JimenaVega/TP-Final-Arquitectura-2021/img/diagrama_completo.png

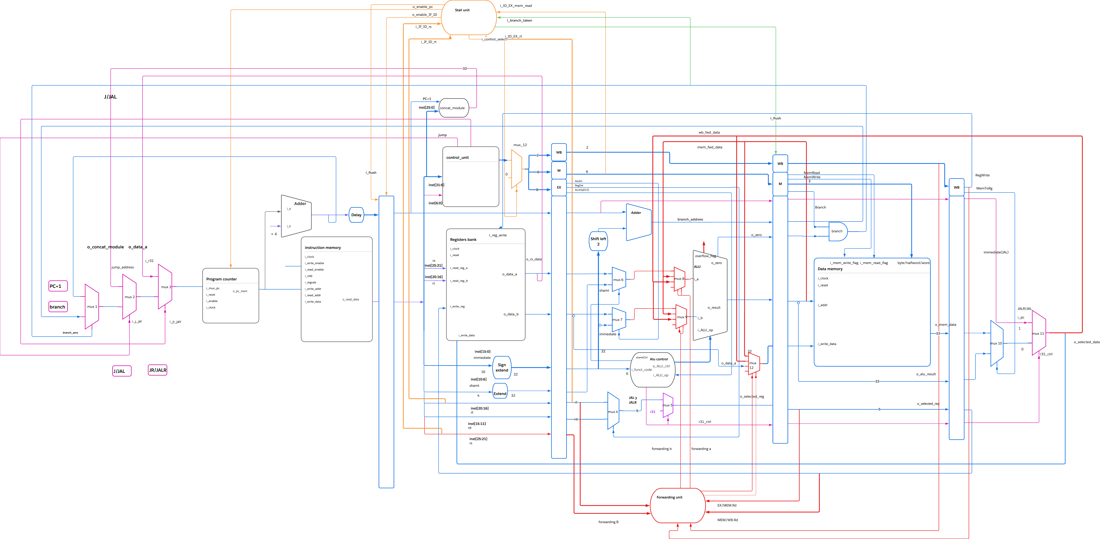
img/diagrama_completo.png
