JimenaVega/TP-Final-Arquitectura-2021/src/control_unit.v

`timescale 1ns / 1ps

module control_unit#(
        parameter   NB_OPCODE       = 6,
        parameter   NB_FUNCT        = 6,
        //Instruction OPCODEs
        parameter   RTYPE_OPCODE    = 6'h00,
        parameter   BEQ_OPCODE      = 6'h04, // ITYPE BEQ
        parameter   BNE_OPCODE      = 6'h05, // ITYPE BNE
        parameter   ADDI_OPCODE     = 6'h08, // ITYPE ADDI
        parameter   SLTI_OPCODE     = 6'h0a, // ITYPE SLTI
        parameter   ANDI_OPCODE     = 6'h0c, // ITYPE ANDI
        parameter   ORI_OPCODE      = 6'h0d, // ITYPE ORI
        parameter   XORI_OPCODE     = 6'h0e, // ITYPE XORI
        parameter   LUI_OPCODE      = 6'h0f, // ITYPE LUI
        parameter   LB_OPCODE       = 6'h20, // ITYPE LB
        parameter   LH_OPCODE       = 6'h21, // ITYPE LH
        parameter   LHU_OPCODE      = 6'h22, // ITYPE LHU
        parameter   LW_OPCODE       = 6'h23, // ITYPE LW
        parameter   LWU_OPCODE      = 6'h24, // ITYPE LWU
        parameter   LBU_OPCODE      = 6'h25, // ITYPE LBU
        parameter   SB_OPCODE       = 6'h28, // ITYPE SB
        parameter   SH_OPCODE       = 6'h29, // ITYPE SH
        parameter   SW_OPCODE       = 6'h2b, // ITYPE SW
        parameter   J_OPCODE        = 6'h02, // JTYPE J
        parameter   JAL_OPCODE      = 6'h03, // JTYPE JAL
        parameter   JALR_FUNCT      = 6'h09,
        parameter   JR_FUNCT        = 6'h08,
        parameter   HLT_OPCODE      = 6'h3f
    )
    (   input                       i_clock,
        input                       i_enable,
        input                       i_reset,        // Necesario para flush en controls hazard
        input [NB_OPCODE-1:0]       i_opcode,
        input [NB_FUNCT-1:0]        i_funct,
        input                       i_ctrl_sel,     // from STALL UNIT
        
        output reg                  o_signed,
        output reg                  o_reg_dest,     // EX
        output reg [NB_OPCODE-1:0]  o_alu_op,       // EX REG?
        output reg                  o_alu_src,      // EX
        output reg                  o_mem_read,     // MEM
        output reg                  o_mem_write,    // MEM
        output reg                  o_branch,       // MEM
        output reg                  o_reg_write,    // WB
        output reg                  o_mem_to_reg,   // WB
        output reg                  o_jump,
        output reg                  o_byte_en,
        output reg                  o_halfword_en,
        output reg                  o_word_en,
        output reg                  o_jr_jalr,      // Hacia register bank
        output reg                  o_hlt           // END OF PROGRAM
    );

    always@(posedge i_clock) begin
        if(i_reset) begin
            o_alu_op        <= {NB_OPCODE{1'b0}};
            o_signed        <= 1'b0;
            o_reg_dest      <= 1'b0;
            o_alu_src       <= 1'b0;
            o_mem_read      <= 1'b0;
            o_mem_write     <= 1'b0;
            o_branch        <= 1'b0;
            o_reg_write     <= 1'b0;
            o_mem_to_reg    <= 1'b0;
            o_jump          <= 1'b0;
            o_jr_jalr       <= 1'b0;
            o_byte_en       <= 1'b0;
            o_halfword_en   <= 1'b0;
            o_word_en       <= 1'b0;
            o_hlt           <= 1'b0;
        end
        if(i_enable) begin
            if(!i_ctrl_sel) begin
                o_alu_op <= i_opcode;
                case(i_opcode)
                    RTYPE_OPCODE:begin
                        o_signed        <= 1'b0;
                        o_reg_dest      <= 1'b1; // rd
                        o_alu_src       <= 1'b0; // rt
                        o_mem_read      <= 1'b0; // no accede a mem
                        o_mem_write     <= 1'b0; // no accede a mem
                        o_branch        <= 1'b0; // no es branch
                        o_reg_write     <= 1'b1; // escribe en bank register
                        o_mem_to_reg    <= 1'b0; // read salida ALU
                        o_jump          <= 1'b0;
                        o_byte_en       <= 1'b0;
                        o_halfword_en   <= 1'b0;
                        o_word_en       <= 1'b0;
                        o_hlt           <= 1'b0;

                        if((i_funct == JALR_FUNCT) || (i_funct == JR_FUNCT)) begin
                            o_jr_jalr <= 1'b1; // Ambas escriben en el PC=$rs
                        end
                        else begin
                            o_jr_jalr <= 1'b0;
                        end

                    end
                    BEQ_OPCODE:begin
                        o_signed        <= 1'b0;
                        o_reg_dest      <= 1'b0; // X
                        o_alu_src       <= 1'b0; // rt
                        o_mem_read      <= 1'b0; // no accede a mem
                        o_mem_write     <= 1'b0; // no accede a mem
                        o_branch        <= 1'b1; // es branch
                        o_reg_write     <= 1'b0; // no escribe en bank register
                        o_mem_to_reg    <= 1'b0; // X
                        o_jump          <= 1'b0;
                        o_byte_en       <= 1'b0;
                        o_halfword_en   <= 1'b0;
                        o_word_en       <= 1'b0;
                        o_jr_jalr       <= 1'b0;
                        o_hlt           <= 1'b0;
                    end
                    BNE_OPCODE:begin
                        o_signed        <= 1'b0;
                        o_reg_dest      <= 1'b0; // X
                        o_alu_src       <= 1'b0; // rt
                        o_mem_read      <= 1'b0; // no accede a mem
                        o_mem_write     <= 1'b0; // no accede a mem
                        o_branch        <= 1'b1; // es branch
                        o_reg_write     <= 1'b0; // no escribe en bank register
                        o_mem_to_reg    <= 1'b0; // X
                        o_jump          <= 1'b0;
                        o_byte_en       <= 1'b0;
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
                        o_signed        <= 1'b0;
                        o_reg_dest      <= 1'b0; // rt
                        o_alu_src       <= 1'b0; // immediate
                        o_mem_read      <= 1'b0; // no read mem
                        o_mem_write     <= 1'b0; // no write mem
                        o_branch        <= 1'b0; // no es branch
                        o_reg_write     <= 1'b0; // escribe en rt
                        o_mem_to_reg    <= 1'b0; // X
                        o_jump          <= 1'b1;
                        o_byte_en       <= 1'b0;
                        o_halfword_en   <= 1'b0;
                        o_word_en       <= 1'b0;
                        o_jr_jalr       <= 1'b0;
                        o_hlt           <= 1'b0;
                    end
                    JAL_OPCODE:begin
                        o_signed        <= 1'b0;
                        o_reg_dest      <= 1'b0; // rt
                        o_alu_src       <= 1'b0; // immediate
                        o_mem_read      <= 1'b0; // no read mem
                        o_mem_write     <= 1'b0; // no write mem
                        o_branch        <= 1'b0; // no es branch
                        o_reg_write     <= 1'b1; // escribe en rt
                        o_mem_to_reg    <= 1'b0; // X
                        o_jump          <= 1'b1; // TODO: ver si se necesta señal que haga $ra=PC+1
                        o_byte_en       <= 1'b0;
                        o_halfword_en   <= 1'b0;
                        o_word_en       <= 1'b0;
                        o_jr_jalr       <= 1'b0;
                        o_hlt           <= 1'b0;
                    end
                    HLT_OPCODE:begin
                        o_signed        <= 1'b0;
                        o_reg_dest      <= 1'b0; // rt
                        o_alu_src       <= 1'b0; // immediate
                        o_mem_read      <= 1'b0; // no read mem
                        o_mem_write     <= 1'b0; // no write mem
                        o_branch        <= 1'b0; // no es branch
                        o_reg_write     <= 1'b0; // escribe en rt
                        o_mem_to_reg    <= 1'b0; // X
                        o_jump          <= 1'b0; // dont jump
                        o_byte_en       <= 1'b0;
                        o_halfword_en   <= 1'b0;
                        o_word_en       <= 1'b0;
                        o_jr_jalr       <= 1'b0;
                        o_hlt           <= 1'b1; // END OF PROGRAM
                    end
                    default: begin
                        o_signed        <= 1'b0;
                        o_reg_dest      <= 1'b0; // rt
                        o_alu_src       <= 1'b0; // immediate
                        o_mem_read      <= 1'b0; // no read mem
                        o_mem_write     <= 1'b0; // no write mem
                        o_branch        <= 1'b0; // no es branch
                        o_reg_write     <= 1'b0; // escribe en rt
                        o_mem_to_reg    <= 1'b0; // X
                        o_jump          <= 1'b0; // dont jump
                        o_byte_en       <= 1'b0;
                        o_halfword_en   <= 1'b0;
                        o_word_en       <= 1'b0;
                        o_jr_jalr       <= 1'b0;
                        o_hlt           <= 1'b0; // END OF PROGRAM
                    end
                endcase
            end
            else begin
                    // flush from STALL UNIT 
                    o_signed        <= 1'b0;
                    o_reg_dest      <= 1'b0; // rt
                    o_alu_src       <= 1'b0; // immediate
                    o_mem_read      <= 1'b0; // no read mem
                    o_mem_write     <= 1'b0; // no write mem
                    o_branch        <= 1'b0; // no es branch
                    o_reg_write     <= 1'b0; // escribe en rt
                    o_mem_to_reg    <= 1'b0; // X
                    o_jump          <= 1'b0; // dont jump
                    o_byte_en       <= 1'b0;
                    o_halfword_en   <= 1'b0;
                    o_word_en       <= 1'b0;
                    o_jr_jalr       <= 1'b0;
                    o_hlt           <= 1'b0; // END OF PROGRAM
            end
        end
        // else begin
        //     o_alu_op        <= {NB_OPCODE{1'b0}};
        //     o_signed        <= 1'b0;
        //     o_reg_dest      <= 1'b0;
        //     o_alu_src       <= 1'b0;
        //     o_mem_read      <= 1'b0;
        //     o_mem_write     <= 1'b0;
        //     o_branch        <= 1'b0;
        //     o_reg_write     <= 1'b0;
        //     o_mem_to_reg    <= 1'b0;
        //     o_jump          <= 1'b0;
        //     o_jr_jalr       <= 1'b0;
        //     o_hlt           <= 1'b0;
        // end
    end
endmodule
    
