JimenaVega/TP-Final-Arquitectura-2021/src/debug_unit.v

`timescale 1ns / 1ps

module debug_unit#(
    parameter NB_STATE    = 10,
    parameter NB_DATA     = 8,
    parameter NB_SIZE     = 16, // 2B x 8 b, el tamaño de los datos a recibir en bits
    parameter N_SIZE      = 2,  // 2B de frame para obtener el total de los datos (size)
    parameter NB_ADDR     = 32,
    parameter NB_ADDR_RB  = 5,
    parameter NB_BYTE_CTR = 2,
    parameter NB_ADDR_DM  = 5, 
    parameter BR_SIZE     = 32,
    parameter DM_DEPTH    = 32,
    parameter DM_WIDTH    = 32,
    parameter RB_DEPTH    = 32,
    parameter IM_DEPTH    = 256,
    parameter NB_PC_CTR   = 2
)    
(
    input                   i_clock,
    input                   i_reset,
    input                   i_hlt,          // proveniente del DATAPATH
    input                   i_rx_done,      // meaning: RX tiene un byte listo para ser leido - UART
    input                   i_tx_done,      // meaning: TX ya envio el byte - UART
    input  [NB_DATA-1:0]    i_rx_data,      // from RX - UART

    input  [NB_ADDR-1:0]    i_pc_value,     // *  data read from PC 
    input  [DM_WIDTH-1:0]   i_dm_data,      // * data read from DATA MEMORY
    input  [NB_ADDR-1:0]    i_br_data,      // *  data read from BANK REGISTER
    output [NB_DATA-1:0]    o_im_data,      // *  data to write in INSTRUCTION MEMORY

    output [NB_DATA-1:0]    o_im_addr,      //  * address to write INSTRUCTION MEMORY
    output [NB_ADDR_RB-1:0] o_rb_addr,      // * address to read BANK REGISTER
    output [NB_ADDR_DM-1:0] o_dm_addr,      // * address to read DATA MEMORY

    output [NB_DATA-1:0]    o_tx_data,      // to TX - UART
    output                  o_tx_start,     // to TX - UART

    output                  o_im_write_enable, //*
    output                  o_im_read_enable,
    output                  o_im_enable, //*
    output                  o_rb_read_enable, // * 
    output                  o_rb_enable, // * Usar solo cuando se active funcionamiento normal de datapath
    output                  o_dm_enable, // *
    output                  o_dm_read_enable, // *
    output                  o_dm_du_flag, // *
    output                  o_cu_enable,
    output                  o_pc_enable, // *

    // output                  o_step_flag,
    // output                  o_step,
    output [NB_STATE-1:0]   o_state,
    output                  o_pipeline_enable
);

// States
localparam [NB_STATE-1:0] IDLE         = 10'b0000000001;
localparam [NB_STATE-1:0] WRITE_IM     = 10'b0000000010;
localparam [NB_STATE-1:0] READY        = 10'b0000000100;
localparam [NB_STATE-1:0] START        = 10'b0000001000;
localparam [NB_STATE-1:0] STEP_BY_STEP = 10'b0000010000;
localparam [NB_STATE-1:0] READ_BR      = 10'b0000100000;
localparam [NB_STATE-1:0] SEND_BR      = 10'b0001000000;
localparam [NB_STATE-1:0] READ_MEM     = 10'b0010000000;
localparam [NB_STATE-1:0] SEND_MEM     = 10'b0100000000;
localparam [NB_STATE-1:0] SEND_PC      = 10'b1000000000;

// External commands
localparam [NB_DATA-1:0] CMD_WRITE_IM       = 8'd1; // Escribir programa
localparam [NB_DATA-1:0] CMD_START          = 8'd2; // Ejecucion continua
localparam [NB_DATA-1:0] CMD_STEP_BY_STEP   = 8'd3; // Step-by-step
localparam [NB_DATA-1:0] CMD_SEND_BR        = 8'd4; // Leer bank register
localparam [NB_DATA-1:0] CMD_SEND_MEM       = 8'd5; // Leer data memory
localparam [NB_DATA-1:0] CMD_SEND_PC        = 8'd6; // Leer PC
localparam [NB_DATA-1:0] CMD_STEP           = 8'd7; // Send step
localparam [NB_DATA-1:0] CMD_CONTINUE       = 8'd8; // Continue execution >>


// FSM logic
reg [NB_STATE-1:0]      state,              next_state,     prev_state,   next_prev_state;

// INSTRUCTION MEMORY
reg [NB_DATA-1:0]       im_count,           next_im_count;          // Address a escribir
reg                     im_write_enable,    next_im_write_enable;   // Flag que habilita la escritura del IM
reg                     im_read_enable,     next_im_read_enable;
reg                     im_enable,          next_im_enable;

// DATA MEMORY
reg [NB_ADDR_DM-1:0]    count_dm_tx_done,   count_dm_tx_done_next;  // Address
reg [NB_BYTE_CTR-1:0]   count_dm_byte,      next_count_dm_byte;
reg                     dm_read_enable,     next_dm_read_enable;
reg                     dm_enable,          next_dm_enable;
reg                     dm_du_flag,         next_dm_du_flag;     // selector de address y flag de DU
// BANK REGISTER
reg [NB_ADDR_RB-1:0]    count_br_tx_done,   next_count_br_tx_done; 
reg [NB_BYTE_CTR-1:0]   count_br_byte,      next_count_br_byte;     // cuenta hasta 4 bytes
reg                     rb_read_enable,     next_rb_read_enable;
reg                     rb_enable,          next_rb_enable;

// PC
reg [NB_PC_CTR-1:0]     count_pc,           next_count_pc;
reg                     pc_enable,          next_pc_enable; // 1 -> ejecucion de datapath 0 ->  modo lectura 

// CONTROL UNIT
reg                     cu_enable,          next_cu_enable;

// TX
reg [NB_DATA-1:0]       send_data,          next_send_data;         // DM & BR -> TX
reg                     tx_start,           tx_start_next;

// STEPPER
// reg                     step_flag,          next_step_flag;
// reg                     step,               next_step;

// PIPELINE REGISTERS
reg                    pipeline_enable,     next_pipeline_enable;


// always@(negedge i_clock) begin
//     if (i_reset) begin
//         im_read_enable_delay <= 1'b0;
//         im_enable_delay <= 1'b0;
//         rb_read_enable_delay <= 1'b0;
//         rb_enable_delay <= 1'b0;
//         pipeline_enable_delay <= 1'b0;
//     end
//     else begin
//         im_read_enable_delay <= im_read_enable;
//         im_enable_delay <= im_enable_delay;
//         rb_read_enable_delay <= rb_read_enable;
//         rb_enable_delay <= rb_enable;
//         pipeline_enable_delay <= pipeline_enable;
//     end
    
// end


// Memory
always @(negedge i_clock) begin
    if(i_reset) begin
        state                   <= IDLE;
        prev_state              <= IDLE;

        // INSTRUCTION MEMORY 
        im_write_enable         <= 1'b0;
        im_read_enable          <= 1'b0;
        im_enable               <= 1'b0;
        im_count                <= 8'hff;

        // DATA MEMORY
        count_dm_tx_done        <= 5'b0;
        count_dm_byte           <= 2'b0;
        dm_enable               <= 1'b0;
        dm_read_enable          <= 1'b0;
        dm_du_flag              <= 1'b0;

        // REGISTERS BANK
        count_br_tx_done        <= 5'b0;
        count_br_byte           <= 2'b0;
        rb_enable               <= 1'b0;
        rb_read_enable          <= 1'b0;

        // PC
        pc_enable               <= 1'b0;
        count_pc                <= 2'b0;

        // CONTROL UNIT
        cu_enable               <= 1'b0;
        
        // TX
        send_data               <= 8'b0;
        tx_start                <= 1'b0;

        // STEPPER
//        step_flag               <= 1'b0;
//        step                    <= 1'b0;

        pipeline_enable         <= 1'b0;


    end
    else begin
        state               <= next_state;
        prev_state          <= next_prev_state;
        // INSTRUCTION MEMORY
        im_write_enable     <= next_im_write_enable;
        im_read_enable      <= next_im_read_enable;
        im_enable           <= next_im_enable;
        im_count            <= next_im_count;
        // DATA MEMORY
        dm_enable           <= next_dm_enable;
        dm_read_enable      <= next_dm_read_enable;
        count_dm_byte       <= next_count_dm_byte;
        count_dm_tx_done    <= count_dm_tx_done_next;
        dm_du_flag          <= next_dm_du_flag;
        // REGISTERS BANK
        rb_enable           <= next_rb_enable;
        rb_read_enable      <= next_rb_read_enable;
        count_br_byte       <= next_count_br_byte;
        count_br_tx_done    <= next_count_br_tx_done;
        tx_start            <= tx_start_next;
        // PC
        pc_enable           <= next_pc_enable;
        count_pc            <= next_count_pc;
        // step_flag           <= next_step_flag;
//        step                <= next_step;
        // CONTROL UNIT
        cu_enable           <= next_cu_enable;
        // TX
        send_data           <= next_send_data;

        pipeline_enable     <= next_pipeline_enable;

    end
end

// Next sate logic
always @(*) begin
    next_state              = state;

    next_dm_enable          = dm_enable;
    next_dm_read_enable     = dm_read_enable;
    next_dm_du_flag         = dm_du_flag;
    next_count_dm_byte      = count_dm_byte;
    count_dm_tx_done_next   = count_dm_tx_done;

    next_count_br_byte      = count_br_byte;
    next_count_br_tx_done   = count_br_tx_done;

    next_count_pc           = count_pc;
    next_pc_enable          = pc_enable;

    next_im_enable          = im_enable;
    next_im_write_enable    = im_write_enable;
    next_im_read_enable     = im_read_enable;
    next_im_count           = im_count;

    next_rb_enable          = rb_enable;
    next_rb_read_enable     = rb_read_enable;

    next_send_data          = send_data;
    next_cu_enable          = cu_enable;
    next_pipeline_enable    = pipeline_enable;
   
    tx_start_next           = tx_start;

    // next_step_flag          = step_flag;
    // next_step               = step;

    next_prev_state         = prev_state;

    case(state)
        IDLE: begin
            // next_step_flag      = 1'b0;
            // next_step           = 1'b0; // deshabilito las flags

            next_im_enable       = 1'b0;
            next_im_write_enable = 1'b0;
            next_im_read_enable  = 1'b0;

            next_rb_enable       = 1'b0;
            next_rb_read_enable  = 1'b0;

            next_dm_enable       = 1'b0;
            next_dm_read_enable  = 1'b0;
            next_dm_du_flag      = 1'b0;

            next_cu_enable       = 1'b0;
            next_pc_enable       = 1'b0;
            next_pipeline_enable = 1'b0;

            next_send_data       = 8'b0;


            if(i_rx_done) begin
                case (i_rx_data)
                    CMD_WRITE_IM:  begin
                        next_state = WRITE_IM;
                        next_prev_state = IDLE;
                    end
                    CMD_SEND_BR:begin
                        next_rb_read_enable = 1'b1; // Read enable = register bank con lectura para debug unit
                        next_rb_enable      = 1'b0; // Enable = register bank con lectura en funcionamiento normal

                        next_state = READ_BR;
                        
                        next_prev_state = IDLE;
                    end
                    CMD_SEND_PC:begin
                        next_state = SEND_PC;
                        next_prev_state = IDLE;
                    end
                    CMD_SEND_MEM:begin
                        next_dm_read_enable     = 1'b1;
                        next_dm_enable          = 1'b1;
                        next_dm_du_flag         = 1'b1; // select DU as address and read enable source

                        next_state = READ_MEM;
                        next_prev_state = IDLE;
                    end
                endcase
            end
        end
        READY: begin
            // next_step = 1'b0; // deshabilito las flags
            if(i_rx_done)begin
                case(i_rx_data)
                    CMD_STEP_BY_STEP:   next_state = STEP_BY_STEP;
                    CMD_START:          next_state = START;
                    // default:            next_state = READY;
                endcase
            end
        end
        START: begin
            // next_step_flag  = 1'b0;
            // next_step           = 1'b1; 

            next_im_enable      = 1'b1;
            next_im_read_enable = 1'b1;
            next_rb_enable      = 1'b1;
            next_dm_enable      = 1'b1;
            next_cu_enable      = 1'b1;
            next_pc_enable      = 1'b1;
            next_pipeline_enable = 1'b1;

            if(i_hlt)begin
                next_state = IDLE;
            end
        end
        STEP_BY_STEP: begin
            // next_step_flag  = 1'b1; // STOP 50MHz ckock
            // next_step           = 1'b0;

    

            if(i_rx_done)begin
                next_pipeline_enable = 1'b1;
                case (i_rx_data)
                    CMD_STEP: begin
                        next_state  = SEND_PC;
                        next_prev_state  = STEP_BY_STEP;
                        // next_step   = 1'b1;
                        next_im_enable      = 1'b1;
                        next_im_read_enable = 1'b1;
                        next_rb_enable      = 1'b1;
                        next_dm_enable      = 1'b1;
                        next_cu_enable      = 1'b1;
                        
                        next_pc_enable      = 1'b1;
                    end
                    CMD_CONTINUE: begin
                        next_state = START;
                        next_prev_state = IDLE;
                    end    
                endcase
            end

            if(i_hlt)begin
                next_state = IDLE;
                next_prev_state = IDLE;
            end
        end
        WRITE_IM: begin
            // next_step = 1'b1;
            if(im_count == 8'd254)begin
                next_state              = READY;
                next_im_enable          = 1'b0;
                next_im_read_enable     = 1'b0;
                next_im_write_enable    = 1'b0;
                next_im_count           = 8'hff;
            end
            else begin
                if(i_rx_done)begin
                    next_im_enable          = 1'b1;
                    next_im_write_enable    = 1'b1;
                    next_im_read_enable     = 1'b0;
                    next_im_count           = im_count + 1;
                    next_state              = WRITE_IM;
                end
                else begin
                    next_im_enable          = 1'b0;
                    next_im_write_enable    = 1'b0;
                    next_im_read_enable     = 1'b0;
                end
            end
        end
        SEND_PC: begin
            tx_start_next       = 1'b1;
            // next_step           = 1'b1;

            next_im_enable      = 1'b0;
            next_im_read_enable = 1'b0;
            next_rb_enable      = 1'b0;
            next_dm_enable      = 1'b0;
            next_cu_enable      = 1'b0;
            next_pc_enable      = 1'b0;
            next_pipeline_enable = 1'b0;
            

            case(count_pc)
                2'd0:   next_send_data = i_pc_value[31:24];
                2'd1:   next_send_data = i_pc_value[23:16];
                2'd2:   next_send_data = i_pc_value[15:8];
                2'd3:   next_send_data = i_pc_value[7:0];
            endcase

            if(i_tx_done)begin
                tx_start_next = 1'b0;
                if(count_pc == 2'd3)begin
                    next_pipeline_enable = 1'b0; // por que aca?
                    tx_start_next = 1'b0;
                    next_count_pc = 2'b0;
                    if(prev_state == STEP_BY_STEP)begin
                        next_state = SEND_MEM;
                    end
                    else begin
                        next_state = IDLE;
                    end
                end
                else begin
                    next_count_pc = count_pc + 1;
                    next_state = SEND_PC;
                end
            end
        end
        READ_BR: begin
            next_state = SEND_BR;
        end
        SEND_BR: begin
            next_rb_read_enable = 1'b1; // Read enable = register bank con lectura para debug unit
            next_rb_enable      = 1'b0; // Enable = register bank con lectura en funcionamiento normal
            
            tx_start_next       = 1'b1;
            // next_step           = 1'b1;
            // next_step_flag      = 1'b0; // Se alimenta el datapath con clk de 50MHz

            //disable all except br
            next_pc_enable      = 1'b0;
            next_cu_enable      = 1'b0;
            // next_pipeline_enable = 1'b1; //0
            next_dm_enable      = 1'b0;

            case(next_count_br_byte)
                2'd0:   next_send_data = i_br_data[31:24];
                2'd1:   next_send_data = i_br_data[23:16];
                2'd2:   next_send_data = i_br_data[15:8];
                2'd3:   next_send_data = i_br_data[7:0];
            endcase

            if(i_tx_done)begin
                next_count_br_byte = next_count_br_byte + 1;
                tx_start_next = 1'b0;

                if(count_br_byte == 2'd3)begin
                    next_count_br_tx_done   = count_br_tx_done + 1; // BR address
                    next_count_br_byte      = 2'd0;
                    next_state              = READ_BR;

                    if(count_br_tx_done == RB_DEPTH-1)begin
                        next_rb_read_enable  = 1'b0;
                        tx_start_next        = 1'b0;
                        next_state           = prev_state;
                        tx_start_next        = 1'b0;                    
                    end
                end
            end
        end
        READ_MEM:begin
            next_state = SEND_MEM;
        end
        SEND_MEM: begin
            next_dm_read_enable     = 1'b1;
            next_dm_enable          = 1'b1;
            next_dm_du_flag         = 1'b1; // select DU as address and read enable source
            
            tx_start_next           = 1'b1;
            // next_step               = 1'b1;
            // next_step_flag          = 1'b0;

            // disable all except dm 
            next_im_enable      = 1'b0;
            next_im_read_enable = 1'b0;
            next_rb_enable      = 1'b0;
            next_cu_enable      = 1'b0;
            next_pc_enable      = 1'b0;
            // next_pipeline_enable = 1'b1; // 0

            case(next_count_dm_byte)
                2'd0:   next_send_data = i_dm_data[31:24];
                2'd1:   next_send_data = i_dm_data[23:16];
                2'd2:   next_send_data = i_dm_data[15:8];
                2'd3:   next_send_data = i_dm_data[7:0];
            endcase

            if(i_tx_done)begin
                next_count_dm_byte = next_count_dm_byte + 1;
                tx_start_next = 1'b0;
                
                if(count_dm_byte == 2'd3)begin
                    count_dm_tx_done_next = count_dm_tx_done + 1;
                    next_count_dm_byte = 2'd0;
                    next_state = READ_MEM;

                    if(count_dm_tx_done == DM_DEPTH-1)begin
                        next_dm_read_enable  = 1'b0;
                        next_dm_enable       = 1'b0;
                        next_dm_du_flag      = 1'b0;
                        tx_start_next        = 1'b0;

                        if(prev_state == STEP_BY_STEP) begin
                            next_state = SEND_BR;
                        end
                        else begin
                            next_state = IDLE;
                        end
                    end
                end
            end
        end
    endcase
end

// INSTRUCTION MEMORY
assign o_im_enable          = im_enable;
assign o_im_write_enable    = im_write_enable;
assign o_im_read_enable     = im_read_enable;
assign o_im_data            = i_rx_data;
assign o_im_addr            = im_count;

// DATA MEMORY
assign o_dm_enable          = dm_enable;
assign o_dm_read_enable     = dm_read_enable;
assign o_dm_du_flag         = dm_du_flag;
assign o_dm_addr            = count_dm_tx_done; // Cada vez que haya un tx_done, se avanza +1 address

// REGISTER BANK
assign o_rb_enable          = rb_enable;
assign o_rb_read_enable     = rb_read_enable;
assign o_rb_addr            = count_br_tx_done;

// PC
assign o_pc_enable          = pc_enable;

// CONTROL UNIT
assign o_cu_enable          = cu_enable;

// TX
assign o_tx_data            = send_data;
assign o_tx_start           = tx_start;

// STEPPER
// assign o_step_flag          = step_flag;
// assign o_step               = step;

// STATE
assign o_state              = state;

// PIPELINE REGISTERS
assign o_pipeline_enable = pipeline_enable;

endmodule
