JimenaVega/TP-Final-Arquitectura-2021/src/EX_MEM_reg.v

`timescale 1ns / 1ps

module EX_MEM_reg#(
        parameter NB_PC       = 32,
        parameter NB_REG      = 5
    )
    (
        input                   i_clock,
        input                   i_reset,
        input                   i_pipeline_enable, // DEBUG UNIT
        input                   i_flush,           // STALL UNIT :  1 -> Flush control signals 0 -> !flush
        input                   EX_signed,
        input                   EX_reg_write,
        input                   EX_mem_to_reg,
        input                   EX_mem_read,
        input                   EX_mem_write,
        input                   EX_branch,
        input [NB_PC-1:0]       EX_branch_addr,
        input                   EX_zero,
        input [NB_PC-1:0]       EX_alu_result,
        input [NB_PC-1:0]       EX_data_b,
        input [NB_REG-1:0]      EX_selected_reg,
        input                   EX_byte_en,
        input                   EX_halfword_en,
        input                   EX_word_en,
        input                   EX_r31_ctrl,
        input [NB_PC-1:0]       EX_pc,
        input                   EX_hlt,
        input                   EX_jump,
        input                   EX_jr_jalr,

        output                  MEM_signed,
        output                  MEM_reg_write,
        output                  MEM_mem_to_reg,
        output                  MEM_mem_read,
        output                  MEM_mem_write,
        output                  MEM_branch,
        output [NB_PC-1:0]      MEM_branch_addr,
        output                  MEM_zero,
        output [NB_PC-1:0]      MEM_alu_result,
        output [NB_PC-1:0]      MEM_data_b,
        output [NB_REG-1:0]     MEM_selected_reg,
        output                  MEM_byte_en,
        output                  MEM_halfword_en,
        output                  MEM_word_en,
        output                  MEM_r31_ctrl,
        output [NB_PC-1:0]      MEM_pc,
        output                  MEM_hlt,
        output                  MEM_jump,
        output                  MEM_jr_jalr
    );
    
    reg                 signed_flag;
    reg                 reg_write;
    reg                 mem_to_reg;
    reg                 mem_read;
    reg                 mem_write;
    reg                 branch;
    reg [NB_PC-1:0]     branch_addr;
    reg                 zero;
    reg [NB_PC-1:0]     alu_result;
    reg [NB_PC-1:0]     data_b;
    reg [NB_REG-1:0]    selected_reg;
    reg                 byte_en;
    reg                 halfword_en;
    reg                 word_en;
    reg                 r31_ctrl;
    reg [NB_PC-1:0]     pc;  
    reg                 hlt;
    reg                 jump;
    reg                 jr_jalr;

    always @(negedge i_clock) begin
        if(i_reset) begin
            signed_flag  <= 1'b0;
            reg_write    <= 1'b0;
            mem_to_reg   <= 1'b0;
            mem_read     <= 1'b0;
            mem_write    <= 1'b0;
            branch       <= 1'b0;
            branch_addr  <= 32'b0;
            zero         <= 1'b0;
            alu_result   <= 32'b0;
            data_b       <= 32'b0;
            selected_reg <= 5'b0;
            byte_en      <= 1'b0;
            halfword_en  <= 1'b0;
            word_en      <= 1'b0;
            r31_ctrl     <= 1'b0;
            pc           <= 32'b0;
            hlt          <= 1'b0;
            jump         <= 1'b0;
            jr_jalr      <= 1'b0;
        end
        else begin
            if(i_pipeline_enable) begin
                if(i_flush)begin
                    signed_flag  <= 1'b0;
                    reg_write    <= 1'b0;
                    mem_to_reg   <= 1'b0;
                    mem_read     <= 1'b0;
                    mem_write    <= 1'b0;
                    branch       <= 1'b0;
                    branch_addr  <= EX_branch_addr;
                    zero         <= 1'b0;
                    alu_result   <= EX_alu_result;
                    data_b       <= EX_data_b;
                    selected_reg <= EX_selected_reg;
                    byte_en      <= 1'b0;
                    halfword_en  <= 1'b0;
                    word_en      <= 1'b0;
                    r31_ctrl     <= 1'b0;
                    pc           <= EX_pc;
                    hlt          <= 1'b0;
                    jump         <= 1'b0;
                    jr_jalr      <= 1'b0;
                end
                else begin
                    signed_flag     <= EX_signed;
                    reg_write       <= EX_reg_write;
                    mem_to_reg      <= EX_mem_to_reg;
                    mem_read        <= EX_mem_read;
                    mem_write       <= EX_mem_write;
                    branch          <= EX_branch;
                    branch_addr     <= EX_branch_addr;
                    zero            <= EX_zero;
                    alu_result      <= EX_alu_result;
                    data_b          <= EX_data_b;
                    selected_reg    <= EX_selected_reg;
                    byte_en         <= EX_byte_en;
                    halfword_en     <= EX_halfword_en;
                    word_en         <= EX_word_en;
                    r31_ctrl        <= EX_r31_ctrl;
                    pc              <= EX_pc;
                    hlt             <= EX_hlt;
                    jump            <= EX_jump;
                    jr_jalr         <= EX_jr_jalr;
                end
            end
            else begin
                signed_flag     <= signed_flag;
                reg_write       <= reg_write;
                mem_to_reg      <= mem_to_reg;
                mem_read        <= mem_read;
                mem_write       <= mem_write;
                branch          <= branch;
                branch_addr     <= branch_addr;
                zero            <= zero;
                alu_result      <= alu_result;
                data_b          <= data_b;
                selected_reg    <= selected_reg;
                byte_en         <= byte_en;
                halfword_en     <= halfword_en;
                word_en         <= word_en;
                r31_ctrl        <= r31_ctrl;
                pc              <= pc;
                hlt             <= hlt;
                jump            <= jump;
                jr_jalr         <= jr_jalr;
            end
        end
    end

    assign MEM_signed       = signed_flag;
    assign MEM_reg_write    = reg_write;
    assign MEM_mem_to_reg   = mem_to_reg;
    assign MEM_mem_read     = mem_read;
    assign MEM_mem_write    = mem_write;
    assign MEM_branch       = branch;
    assign MEM_branch_addr  = branch_addr;
    assign MEM_zero         = zero;
    assign MEM_alu_result   = alu_result;
    assign MEM_data_b       = data_b;
    assign MEM_selected_reg = selected_reg;
    assign MEM_byte_en      = byte_en;
    assign MEM_halfword_en  = halfword_en;
    assign MEM_word_en      = word_en;
    assign MEM_r31_ctrl     = r31_ctrl;
    assign MEM_pc           = pc;
    assign MEM_hlt          = hlt;
    assign MEM_jump         = jump;
    assign MEM_jr_jalr      = jr_jalr;
    
endmodule
