JimenaVega/TP-Final-Arquitectura-2021/GUI/translator.py

from numpy import *
from const import *
import os


def jType(instruction):
    result = []
    opcode = mnemonic_code[instruction[0]][0]  # OPCODE
    result.append(bin(opcode)[2:].zfill(6))  # OPCODE

    if instruction[0] != HLT:
        loc = int(instruction[1])
        imm = bin(loc)[2:].zfill(26)
    else:
        imm = bin(0)[2:].zfill(26)

    result.append(imm)  # imm

    bin_val = ''.join(result)
    hex_val = hex(int('0b' + bin_val, 2))[2:].zfill(8)
    return hex_val, bin_val


def rType(instruction):
    result = []
    shift = 0
    shamt = [SLL, SRL, SRA]  # Instructions that use shamt field
    shift_value = [SLLV, SRLV, SRAV]  # Instructions that use rs instead of shamt
    jumps = [JR, JALR]

    opcode = mnemonic_code[instruction[0]][0]  # OPCODE
    result.append(bin(opcode)[2:].zfill(6))  # OPCODE

    if instruction[0] in shamt:
        shift = int(instruction[3])  # shamt

        result.append(bin(opcode)[2:].zfill(5))

        rt = get_register(instruction[2])
        result.append(bin(rt)[2:].zfill(5))  # rt

        rd = get_register(instruction[1])
        result.append(bin(rd)[2:].zfill(5))  # rd

    elif instruction[0] in shift_value:
        rs = get_register(instruction[3])  # rs
        result.append(bin(rs)[2:].zfill(5))  # rs

        rt = get_register(instruction[2])
        result.append(bin(rt)[2:].zfill(5))  # rt

        rd = get_register(instruction[1])
        result.append(bin(rd)[2:].zfill(5))  # rd

    elif instruction[0] in jumps:
        rs = get_register(instruction[1])
        result.append(bin(rs)[2:].zfill(5))  # rs
        print('R rs: ', rs)
        rt = 0
        result.append(bin(rt)[2:].zfill(5))

        rd = 0
        result.append(bin(rd)[2:].zfill(5))
    else:

        rs = get_register(instruction[2])
        result.append(bin(rs)[2:].zfill(5))  # rs

        rt = get_register(instruction[3])
        result.append(bin(rt)[2:].zfill(5))  # rt

        rd = get_register(instruction[1])
        result.append(bin(rd)[2:].zfill(5))  # rd

    result.append(bin(shift)[2:].zfill(5))  # shift

    func = mnemonic_code[instruction[0]][1]  # Func Code
    result.append(bin(func)[2:].zfill(6))

    bin_val = ''.join(result)
    hex_val = hex(int('0b' + bin_val, 2))[2:].zfill(8)
    return hex_val, bin_val


def iType(instruction):
    load_store = [LB, LH, LHU, LW, LWU, LBU, SB, SH, SW]
    result = []
    opcode = mnemonic_code[instruction[0]][0]
    result.append(bin(opcode)[2:].zfill(6))  # OPCODE

    rt = get_register(instruction[1])

    if instruction[0] in load_store:
        baseAndImm = instruction[2].split('(')

        rs = get_register(baseAndImm[1][:-1])
        result.append(bin(rs)[2:].zfill(5))  # rs

        result.append(bin(rt)[2:].zfill(5))  # rt

        imm_b = bin(int(baseAndImm[0]) & 0xffffffff)[2:]
        imm = imm_b.zfill(16) if int(baseAndImm[0]) >= 0 else imm_b[16:]
        result.append(imm)

    elif instruction[0] == LUI:

        rs = 0
        result.append(bin(rs)[2:].zfill(5))

        result.append(bin(rt)[2:].zfill(5))  # rt

        imm_b = bin(int(instruction[2]) & 0xffffffff)[2:]
        imm = imm_b.zfill(16) if int(instruction[2]) >= 0 else imm_b[16:]
        result.append(imm)

    else:
        rs = get_register(instruction[2])
        result.append(bin(rs)[2:].zfill(5))  # rs

        result.append(bin(rt)[2:].zfill(5))  # rt

        imm_b = bin(int(instruction[3]) & 0xffffffff)[2:]
        imm = imm_b.zfill(16) if int(instruction[3]) >= 0 else imm_b[16:]
        result.append(imm)

    bin_val = ''.join(result)
    hex_val = hex(int('0b' + bin_val, 2))[2:].zfill(8)
    return hex_val, bin_val


def get_register(value):
    return registers[value[1:]]


def get_separeted_instruction(line):
    line_split = line.split(" ")

    if line == HLT:
        return line_split

    split_second = line_split.pop(1).split(",")
    line_split.extend(split_second)
    return line_split


def parse_in_bytes(line, n=8):
    return [line[i:i + n] for i in range(0, len(line), n)]


def convert_instruction(line, choice):
    separated = get_separeted_instruction(line)
    converted = mnemonic_type[separated[0]](separated)
    parsed_string = parse_in_bytes(converted[1]) if choice else parse_in_bytes(converted[0], n=2)
    return parsed_string


registers = {
    'zero': 0, 'at': 1, 'v0': 2, 'v1': 3,
    'a0': 4, 'a1': 5, 'a2': 6, 'a3': 7,
    't0': 8, 't1': 9, 't2': 10, 't3': 11,
    't4': 12, 't5': 13, 't6': 14, 't7': 15,
    's0': 16, 's1': 17, 's2': 18, 's3': 19,
    's4': 20, 's5': 21, 's6': 22, 's7': 23,
    't8': 24, 't9': 25, 'k0': 26, 'k1': 27,
    'gp': 28, 'sp': 29, 'fp': 30, 'ra': 31
}

mnemonic_code = {

    ADD: (0, 0x20), ADDU: (0, 0x21), SUB: (0, 0x22), SUBU: (0, 0x23),
    AND: (0, 0x24), OR: (0, 0x25), NOR: (0, 0x27), XOR: (0, 0x26), SLT: (0, 0x2a),

    SLL: (0, 0x00), SRL: (0, 0x02), SRA: (0, 0x3), SLLV: (0, 0x4), SRLV: (0, 0x6), SRAV: (0, 0x7),

    LB: (0x20, 0), LH: (0x21, 0), LHU: (0x22, 0), LW: (0x23, 0), LWU: (0x24, 0), LBU: (0x25, 0),
    SB: (0x28, 0), SH: (0x29, 0), SW: (0x2b, 0),

    ADDI: (0x8, 0), ANDI: (0xc, 0), ORI: (0xd, 0), XORI: (0xe, 0),
    LUI: (0xf, 0), SLTI: (0xa, 0), BEQ: (0x4, 0), BNE: (0x5, 0),

    J: (0x2, 0), JALR: (0, 0x9), JR: (0, 0x8), JAL: (0x3, 0), HLT: (0x3f, 0),
}

mnemonic_type = {
    ADD: rType, ADDU: rType, SUB: rType, SUBU: rType,
    AND: rType, OR: rType, NOR: rType, XOR: rType,

    SLL: rType, SLLV: rType, SRLV: rType, SRAV: rType,
    SLT: rType, SRL: rType, SRA: rType,

    LB: iType, LBU: iType, LH: iType, LHU: iType, LW: iType, LWU: iType,
    SB: iType, SH: iType, SW: iType,

    ADDI: iType, ANDI: iType, ORI: iType, XORI: iType,
    LUI: iType, SLTI: iType, BEQ: iType, BNE: iType,

    J: jType, JAL: jType, JALR: rType, JR: rType, HLT: jType,
}


# INPUT_FILE_NAME = 'control_hazard.txt'
# OUTPUT_FILE_NAME = 'inst.mem'

def get_zeros_to_attach(file_name):
    """
    Retorna la cantidad de lineas que tiene el archivo
    """
    fp = open(file_name, 'r')
    fp_lines = len(fp.readlines())
    fp.close()
    return fp_lines


def translate_file(file_name):
    IN_FP_PATH = './programs/' + file_name + ".txt"
    OUT_FP_PATH = './bin/' + file_name + ".mem"

    file_size = get_zeros_to_attach(IN_FP_PATH)
    zero_fillers = int((256 - file_size * 4) / 4)  # Necesario porque siempre se envian 256 datos por UART

    inp_file = open(IN_FP_PATH, 'r')
    out_file = open(OUT_FP_PATH, 'w')

    line = inp_file.readline()
    # choice = int(input("Choose conversion to binary [1] or hex [0]: "))
    choice = 1  # always binary
    print('Converting file assembler to .mem binary...')

    while line:
        bin_hex = convert_instruction(line[:-2], choice)

        for byte in bin_hex:
            out_file.write(byte + '\n')

        line = inp_file.readline()

    for i in range(zero_fillers):
        bin_hex = convert_instruction('sll $zero,$zero,0', choice)

        for byte in bin_hex:
            out_file.write(byte + '\n')

    print('Conversion ready. Saved in: ' + OUT_FP_PATH)

    inp_file.close()
    out_file.close()

    return OUT_FP_PATH, file_size

# INPUT_FILE_NAME = 'instructions.txt'
# OUTPUT_FILE_NAME = 'instructions.mem'


# def main():
#     inp_file = open(INPUT_FILE_NAME, 'r')
#     out_file = open(OUTPUT_FILE_NAME, 'w')

#     line = inp_file.readline()
#     choice = int(input("Choose conversion to binary [1] or hex [0]: "))
#     print('Converting file assembler to .mem binary...')

#     while line:
#         bin_hex = convert_instruction(line[:-2], choice)

#         for byte in bin_hex:
#             out_file.write(byte + '\n')

#         line = inp_file.readline()

#     print('Conversion ready.')
#     print('Saved in', OUTPUT_FILE_NAME)

#     inp_file.close()
#     out_file.close()


# if __name__ == "__main__":
#     main()
