JimenaVega/TP-Final-Arquitectura-2021/sim/tb_data_memory.v

`timescale 1ns / 1ps

module tb_data_memory;

  // Parameters
  localparam  MEMORY_WIDTH = 8;
  localparam  MEMORY_DEPTH = 128;
  localparam  NB_ADDR = 7;
  localparam  NB_DATA = 32;
  localparam  RAM_PERFORMANCE = "LOW_LATENCY";
  localparam  INIT_FILE = "";

  // Ports
  reg i_clock = 0;
  reg i_mem_write_flag = 0;
  reg i_mem_read_flag = 0;
  reg i_word_en = 0;
  reg i_halfword_en = 0;
  reg i_byte_en = 0;
  reg [NB_ADDR-1:0] i_address;
  reg [NB_DATA-1:0] i_write_data;
  wire [NB_DATA-1:0] o_read_data;

  data_memory 
  #(
    .MEMORY_WIDTH(MEMORY_WIDTH ),
    .MEMORY_DEPTH(MEMORY_DEPTH ),
    .NB_ADDR(NB_ADDR ),
    .NB_DATA(NB_DATA ),
    .RAM_PERFORMANCE(RAM_PERFORMANCE ),
    .INIT_FILE (
        INIT_FILE )
  )
  data_memory_1 (
    .i_clock (i_clock ),
    .i_mem_write_flag (i_mem_write_flag ),
    .i_mem_read_flag (i_mem_read_flag ),
    .i_word_en (i_word_en ),
    .i_halfword_en (i_halfword_en ),
    .i_byte_en (i_byte_en ),
    .i_address (i_address ),
    .i_write_data (i_write_data ),
    .o_read_data  ( o_read_data)
  );

  initial begin
    begin
      i_mem_write_flag  = 1'b1;
      i_mem_read_flag   = 1'b0;
      
      i_word_en         = 1'b1;
      i_halfword_en     = 1'b0;
      i_byte_en         = 1'b0;
      i_address         = 7'd0;
      i_write_data      = 32'hffffffff;
      
      #20
      
      i_word_en         = 1'b0;
      i_halfword_en     = 1'b0;
      i_byte_en         = 1'b1;
      i_address         = 7'd0;
      i_write_data      = 32'h0;
      
      #20
      
      i_word_en         = 1'b0;
      i_halfword_en     = 1'b1;
      i_byte_en         = 1'b0;
      i_address         = 7'd10;
      i_write_data      = 32'hffffffff;
      
      #20
      
      i_mem_write_flag  = 1'b0;
      i_mem_read_flag   = 1'b1;
      
      i_word_en         = 1'b0;
      i_halfword_en     = 1'b1;
      i_byte_en         = 1'b0;
      i_address         = 7'd0;
      
      #20
      
      i_word_en         = 1'b1;
      i_halfword_en     = 1'b0;
      i_byte_en         = 1'b0;
      i_address         = 7'd0;
      
      #20
      
      i_word_en         = 1'b0;
      i_halfword_en     = 1'b0;
      i_byte_en         = 1'b1;
      i_address         = 7'd10;
      
      #20
      
      i_word_en         = 1'b1;
      i_halfword_en     = 1'b0;
      i_byte_en         = 1'b0;
      i_address         = 7'd10;
      
      $finish;
    end
  end

  always
    #5  i_clock = ! i_clock ;

endmodule
