JimenaVega/TP-Final-Arquitectura-2021/(commit log)

2023-01-13 Agregada memoria de instrucciones, sin testear
2023-01-13 Testbench de adder y PC juntos
2023-01-19 Testbench de instruction_memory, falta testear inicializacion de la memoria
2023-01-19 Inicializacion de memoria funcionando
2023-01-19 Testbench de mux4 agregado
2023-01-20 Testbench de registers_bank
2023-01-20 Instrucciones MIPS agregadas al diccionario de opcodes
2023-01-26 Conversor con seleccion de binario/hexa, con intrucciones agregadas y con output.mem
2023-01-28 Añadidas instrucciones tipo i y el immediate acepta numero negativos
2023-01-28 Arreglado error en LUI, correccion de const
    [const.py, translator.py]
2023-02-04 Cambios en orden y nombres de variables
2023-02-06 Cambiado nombres de variables
2023-02-06 Correcion en algunos codigos de operacion de la señalAALUctrl en ALU y alu control
2023-02-09 Agregado testbench de sign_extend
2023-02-10 Agregado testbench de control_unit
2023-02-13 Modulo de jump: concat_module añadido junto con tb sin comprobar en vivado
2023-02-13 Fixeando conflicto de merge
    [sign_extend.v]
2023-02-19 Modulo ID añadido, formato de concat_module, en control unit se añade J y JAL
2023-02-24 Añadido el testbench de ID stage sin simular aun
2023-03-03 Correcciones de sintaxis
2023-03-03 Agregado testbench de WB y modificaciones en testbench de MEM
2023-03-04 Warnings y errores de sintaxis arreglados
    [ID_stage.v, control_unit.v, tb_ID_stage.v, tb_MEM_stage.v, tb_concat_module.v]
2023-03-06 Data memory ahora de 8 bits
2023-03-11 Agregado testbench de program_counter
2023-03-11 Testbench de IF_stage agregado
    Funciona, solo hay que cambiar la instruction_memory para que tenga 8 bits de ancho y generar un archivo .mem acorde
2023-03-11 instruction_memory ahora es de 8 bits de ancho
2023-03-11 Se quita High Performance y Write de instruction_memory
2023-03-11 Testbench de MEM_stage funcionando
2023-03-17 Normalizando nombres de variables
2023-03-17 Normalizacion de nombres
2023-03-17 Correciones en testbench de EX
2023-03-17 Flags de byte, halfword y word agregadas
2023-03-18 Agregado shamt en ID, pipeline reg ID/EX y en EX, junto con sus testench. Tambien agregadas inst de shift en tb
2023-03-19 bug fix error de traduccion en LUI
    [translator.py]
2023-03-19 Bug fix en translator, campos rd, rs, rt
    [translator.py]
2023-03-19 Agregados testeos de intrucciones tipo I
2023-03-24 Fixes y avances en tb_TOP
    [ID_stage.v, MEM_stage.v, TOP.v, alu.v, tb_MEM_stage.v, tb_TOP.v]
2023-03-24 Arreglo en errores de alu, tb ex stage y ex stage
    [EX_stage.v, alu.v, tb_EX_stage.v]
2023-03-26 Añadida stall unit
2023-03-31 Cambios para JR y JAL en ID, sus modulos y testbenchs
2023-03-31 Agregadas flags y muxes para JAL y JALR
2023-03-31 Mofidicado IF stage para J,JAL,JR y JALR
2023-04-06 Forwarding unit y stall unit corregidas
    [forwarding_unit.v, stall_unit.v]
2023-04-06 bug fix en mux de IF
    [ID_stage.v, IF_stage.v, TOP.v, control_unit.v, tb_ID_stage.v]
2023-04-07 Translator parsea de a byte
2023-04-14 Delay en control unit para sincronizacion con register bank agregada
2023-04-14 Agregado delay de inst en ID_stage
2023-04-14 Bug fix: conectado shamt
    [ID_EX_reg.v]
2023-04-16 Fixed shamt in EX stage
    [ID_stage.v]
2023-04-18 Bug fix: mux 5 y 4 en EX
    [EX_stage.v]
2023-04-20 Bug fix MEM stage
    [EX_MEM_reg.v, TOP.v, translator.py]
2023-04-20 Bug fix: selected reg en WB stage
    [TOP.v, WB_stage.v]
2023-04-20 Cambios en nombres de mux
2023-04-21 Bug fix registro interno de pipeline register MEM/WB
    [MEM_WB_reg.v]
2023-04-21 Bug fix, orden de operandos en translator para op tipo R
    [translator.py]
2023-04-27 Agregado modulo UART
2023-04-30 Agregada entrada de escritura para INSTRUCTION MEMORY
2023-04-30 Borrado de cosas innecesarias
2023-05-04 Synthesis - Fix en anchos
    [ID_stage.v, control_unit.v]
2023-05-04 Synthesis - Warnings fix
    [MEM_stage.v, alu_control.v, concat_module.v, tb_concat_module.v]
2023-05-05 Agregado clock de clock_wizard
2023-05-11 Agregadas señales de la Debug Unit en DataPath
2023-05-13 Overflow detection para todos los adds y subs
2023-05-15 Fix mas random que randomito
    [data_memory.v, debug_unit.v]
2023-05-18 Stall unit aun sin andar
    [ID_stage.v, IF_ID_reg.v, IF_stage.v, TOP.v, control_unit.v, program_counter.v, registers_bank.v, stall_unit.v]
2023-05-18 Bug fix: forwarding unit
    [forwarding_unit.v]
2023-05-19 Envio de data_memory funcionando
2023-05-19 Envio de registers_bank funcionando
2023-05-19 Envio de pc funcionando
2023-05-19 Nuevo ejemplo de control_hazard.txt
2023-05-20 Comienzo de gui
2023-05-22 test uart
2023-05-25 GUI envia un archivo por uart, aun no recibe y aun no ejecuta debug mode aunque las ventanas estan seteadas
2023-05-28 Modificiaciones para debuggear
2023-05-29 Wirte IM agregado
2023-05-29 Agregado handler para cerrar puerto
2023-05-29 Modificaciones a gui y uart para etapa de testeo
2023-06-01 Transmision de bytes working just finee
2023-06-01 Test uart with just rx
2023-06-01 lecturas de RX uart en register bank sin testear
2023-06-02 TOP de DebugUnit, data_path y UART_du
2023-06-02 Lectura y gaurdado de bytes enviados por los 3 tipos de memorias correcto
    [gui.py, uart.py]
2023-06-05 Cambio de states en Step by step agragado
2023-06-09 Synthesis fixes (IM flags)
    [TOP.v, debug_unit.v, instruction_memory.v, registers_bank.v, tb_TOP.v]
2023-06-09 Debug unit RB fix
    [debug_unit.v, registers_bank.v, tb_TOP.v]
2023-06-11 Warning input EX_rs has an internal driver fixed
    [ID_EX_reg.v]
2023-06-11 Intento cambio de lectura comb a secuen.
2023-06-12 Warning de cables sin usar (sin testear)
2023-06-12 Warning i_enable_pc de program counter sin conectar solucionado (datapath sin testear)
2023-06-12 warnings de register banks fixed
    [data_path.v, instruction_memory.v, registers_bank.v, tb_data_path.v, translator.py]
2023-06-15 Warning FSM not used and removed fixed
    [TOP.v, basys3.xdc]
2023-06-16 Info message of no default in cases fixed
    [control_unit.v, debug_unit.v, debug_unit_top.v, instruction_memory.v]
2023-06-16 DM ahora escribe solo 1 pos de memoria
2023-06-16 Cambio tamaño de puertos
2023-06-16 Cambio en envio de dm en debug unit
2023-06-18 Debug unit de prueba agregada y bux fix entre top, debug unit y data mem
    [TOP.v, debug_unit.v, debug_unit_top.v]
2023-06-19 Test de debug unit aun sin andar
2023-06-19 Warning time loop fixed
    [TOP.v, debug_unit.v]
2023-06-19 Warning de time loop fixed
    [TOP.v, basys3.xdc]
2023-06-19 Hasta implementacion andando yay! pero no anda el post synthesis bu
2023-06-20 Binario para llenar instruction memory
2023-06-20 Solucionado error de escritura de memoria
    [TOP_of_tops.v, debug_unit.v, tb_TOP.v]
2023-06-22 Fix en escritura de IM
    [debug_unit.v, tb_TOP.v]
2023-06-22 Fix en modulo extend
    [ID_stage.v, extend.v]
2023-06-22 Agregado delay a la salida del adder del pc
2023-06-22 Testbench para lectura de mems
2023-06-22 Cambios en tb para lectura de memorias
2023-06-23 se forwardea PC en vez de PC+1 a debug unit
2023-06-23 Bug fix entre debug unit y DM
    [MEM_stage.v, data_memory.v, data_path.v, debug_unit.v]
2023-06-23 Testing uart y debug unit
2023-06-23 Fix en envio de DM (hasta cuando sigue esto? basta)
    [debug_unit.v]
2023-06-23 Es un asco, anda todo para el ****
2023-06-24 Lectura de bank register fixed
    [TOP.v, TOP_debug_unit.v, TOP_of_tops.v, basys3.xdc, debug_unit.v, tb_TOP.v, tb_TOP_of_tops.v]
2023-06-26 EScritura de IM + ejecucion + Lectura de BR + Lectura de DM + Lectura de PC en behavioral andando completamente
2023-06-26 Nuevos constraints para top.v
2023-06-29 Bug fix: control unit borra flags cuando i_enable esta bajo
    [control_unit.v, tb_TOP.v]
2023-06-30 Bug fix en escritura y delay de pipelineregister
    [EX_MEM_reg.v, ID_EX_reg.v, IF_ID_reg.v, MEM_WB_reg.v, TOP.v, TOP_of_tops.v, data_path.v, debug_unit.v]
2023-07-01 Fix bug de escritura en DM
    [MEM_stage.v, tb_TOP_of_tops.v]
2023-07-03 Bug fix: warning mem_to_reg eliminado
    [TOP.v, control_unit.v, debug_unit.v, gui.py, uart.py]
2023-07-06 Bug fix gui ahora escribe 256 bytes en archivo de traduccion a bin
    [debug_unit.v, gui.py, tb_TOP.v, tb_TOP_of_tops.v, translator.py]
2023-07-06 Binarios para hazards de 256 bytes añadidos
2023-07-06 bug fix: maxima cantidad de steps
    [gui.py]
2023-07-07 Bug fix: registro se escribia mal tras un raw load hazard
    [registers_bank.v]
2023-07-07 Steps en tb de top cambiado
2023-07-07 programa de jals
2023-07-08 Bug fix: raw con store y beq/bne funcionando al reves
    [EX_stage.v, alu.v, data_path.v, forwarding_unit.v, registers_bank.v]
2023-07-08 Bug fix: jal no guardaba el valor de PC en r31
    [control_unit.v, tb_TOP_of_tops.v]
2023-07-10 Reset de memorias agregados
    [MEM_stage.v, data_memory.v, data_path.v, registers_bank.v]
2023-07-10 Revert "Reset de memorias agregados"
    This reverts commit 7220b85f31ba296a41b053d14fdcd4744be2df20.
    [MEM_stage.v, data_memory.v, data_path.v, registers_bank.v]
2023-07-11 GUI modificada para que muestre decimales
2023-07-13 Flush despues de jumps agregado
2023-07-14 Bug fix: escrituras tras halt
    [data_path.v, forwarding_unit.v, stall_unit.v, tb_TOP_of_tops.v]
2023-07-17 Cambio en step con bugs en escritura y tras elegir continue despues de step
    [TOP.v, TOP_of_tops.v, debug_unit.v, instruction_memory.v, tb_TOP_of_tops.v]
2023-07-18 Cambio de clock en TOP_of_tops
2023-07-20 Bug fix: step by step anda con jalr y jr
    [ID_EX_reg.v, ID_stage.v, data_path.v, tb_TOP_of_tops.v]
2023-07-20 bug fix: flush de jalr y jr
    [EX_MEM_reg.v, data_path.v]
